starduststorm/belt/README.md

belt move, triangle stay put. that's it. that's the concept.
