starduststorm/belt/case/belt_top_case.stl

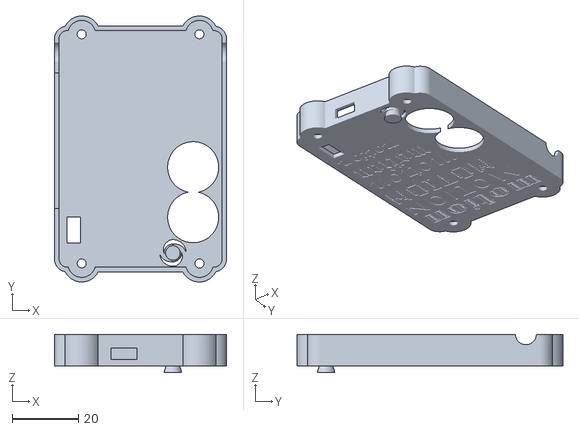
[picture p1: CAD file, 2022-06-10]
case/belt_top_case.stl
52.1 x 80.4 x 11.6
