starduststorm/belt/case/belt_bottom_case.stl

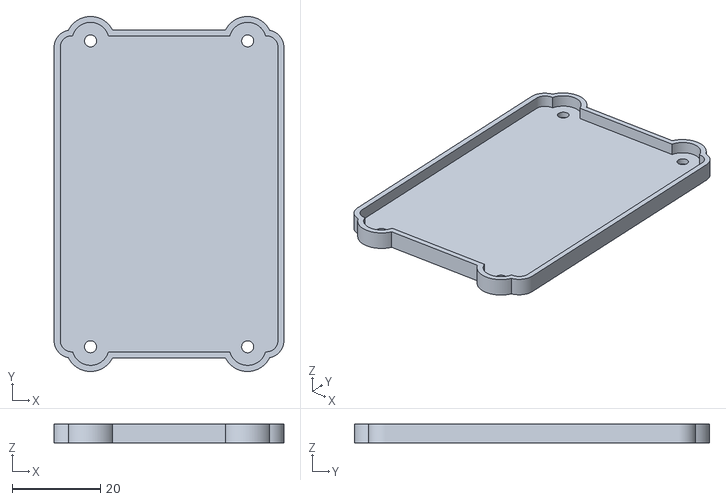
[picture p2: CAD file, 2021-12-14]
case/belt_bottom_case.stl
52.1 x 80.4 x 4.20
