starduststorm/belt/(list of files, cad)

Other CAD files:
case/controller.scad
