starduststorm/belt/board/belt.kicad_pcb

## KiCad design board/belt.kicad_pcb (2021-11-02)

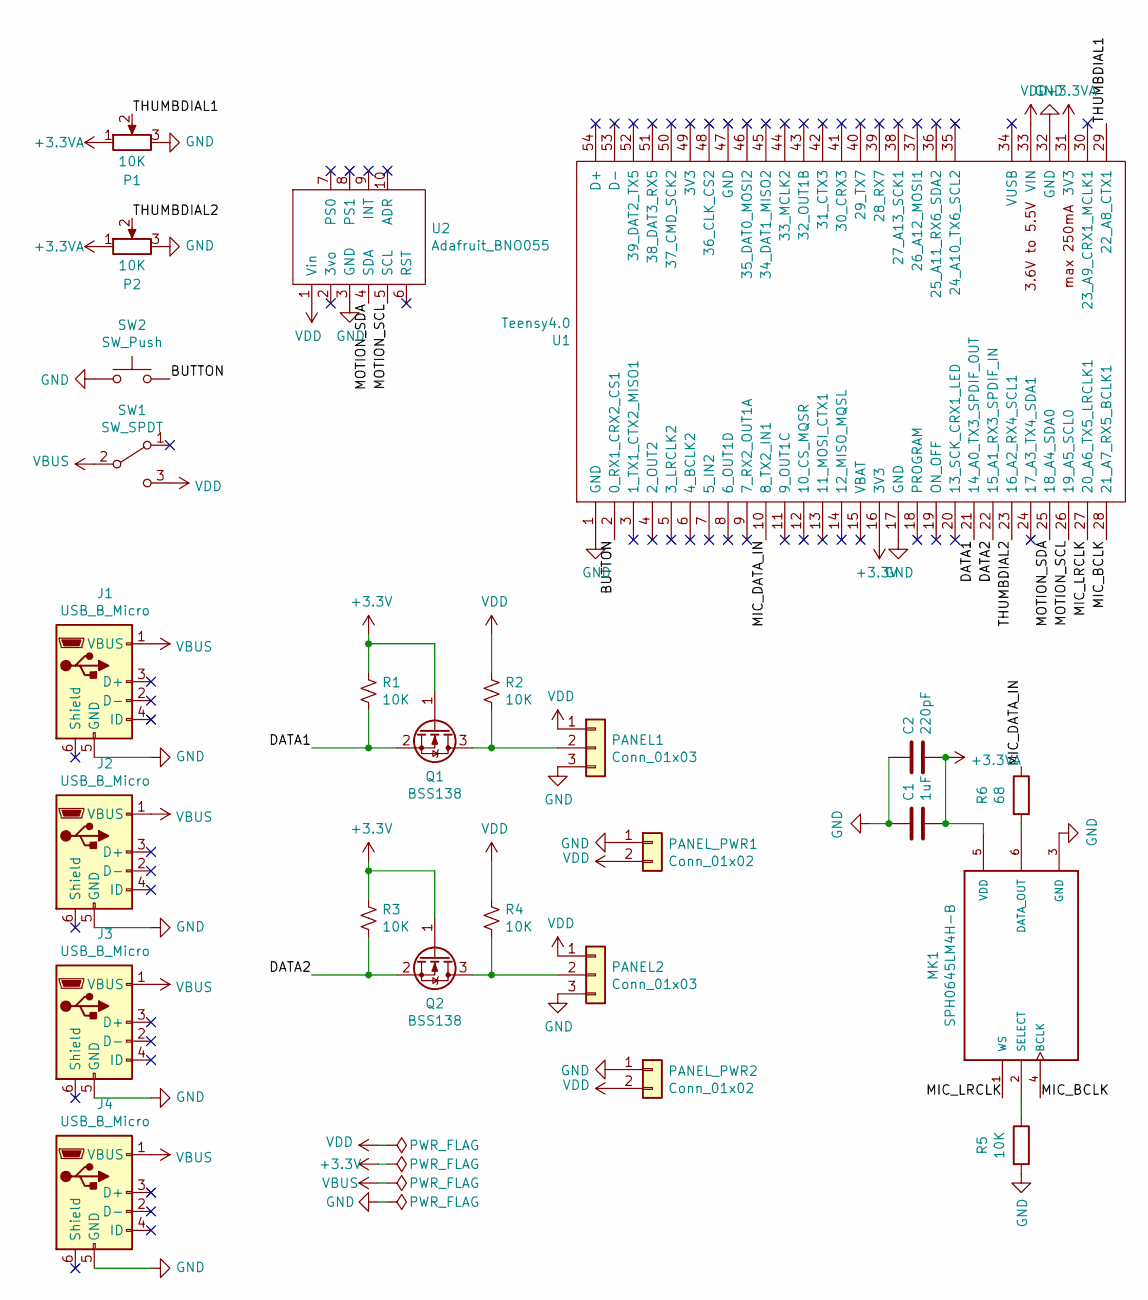
[picture p3: schematic belt.sch]

Parts:
C1: 1uF; C_0805_2012Metric
C2: 220pF; C_0805_2012Metric
J1, J2, J3, J4: USB_B_Micro; USB_Micro-B_Molex-105017-0001
MK1: SPH0645LM4H-B; MIC_SPH0645LM4H-B
P1, P2: 10K; PDB12-H
PANEL1, PANEL2: Conn_01x03; Pad_SMD_01x03
PANEL_PWR1, PANEL_PWR2: Conn_01x02; Pad_SMD_01x02
Q1, Q2: BSS138; SOT-23
R1, R2, R3, R4, R5: 10K; R_0603_1608Metric
R6: 68; R_0805_2012Metric
SW1: SW_SPDT; Button_Switch_SPDT_GH36P010001
SW2: SW_Push; SW_PUSH_6mm_H5mm
U1: Teensy4.0; Teensy40
U2: Adafruit_BNO055

Connections:
+3.3VA: C1.2, C2.2, MK1.5 (VDD), P1.1, P2.1, U1.31 (3V3)
+3V3: Q1.1 (G), Q2.1 (G), R1.1, R3.1, U1.16 (3V3)
/BUTTON: SW2.2, U1.2 (0_RX1_CRX2_CS1)
/DATA1: Q1.2 (S), R1.2, U1.21 (14_A0_TX3_SPDIF_OUT)
/DATA2: Q2.2 (S), R3.2, U1.22 (15_A1_RX3_SPDIF_IN)
/MIC_BCLK: MK1.4 (BCLK), U1.28 (21_A7_RX5_BCLK1)
/MIC_DATA_IN: R6.1, U1.10 (8_TX2_IN1)
/MIC_LRCLK: MK1.1 (WS), U1.27 (20_A6_TX5_LRCLK1)
/MOTION_SCL: U1.26 (19_A5_SCL0), U2.5 (SCL)
/MOTION_SDA: U1.25 (18_A4_SDA0), U2.4 (SDA)
/THUMBDIAL1: P1.2, U1.29 (22_A8_CTX1)
/THUMBDIAL2: P2.2, U1.23 (16_A2_RX4_SCL1)
GND: C1.1, C2.1, J1.5 (GND), J2.5 (GND), J3.5 (GND), J4.5 (GND), MK1.3 (GND), P1.3, P2.3, PANEL1.3, PANEL2.3, PANEL_PWR1.1, PANEL_PWR2.1, R5.2, SW2.1, U1.1 (GND), U1.17 (GND), U1.32 (GND), U2.3 (GND)
unnamed: MK1.2 (SELECT), R5.1
unnamed: MK1.6 (DATA_OUT), R6.2
unnamed: PANEL1.2, Q1.3 (D), R2.2
unnamed: PANEL2.2, Q2.3 (D), R4.2
VBUS: J1.1 (VBUS), J2.1 (VBUS), J3.1 (VBUS), J4.1 (VBUS), SW1.2 (B)
VDD: PANEL1.1, PANEL2.1, PANEL_PWR1.2, PANEL_PWR2.2, R2.1, R4.1, SW1.3 (C), U1.33 (VIN), U2.1 (Vin)

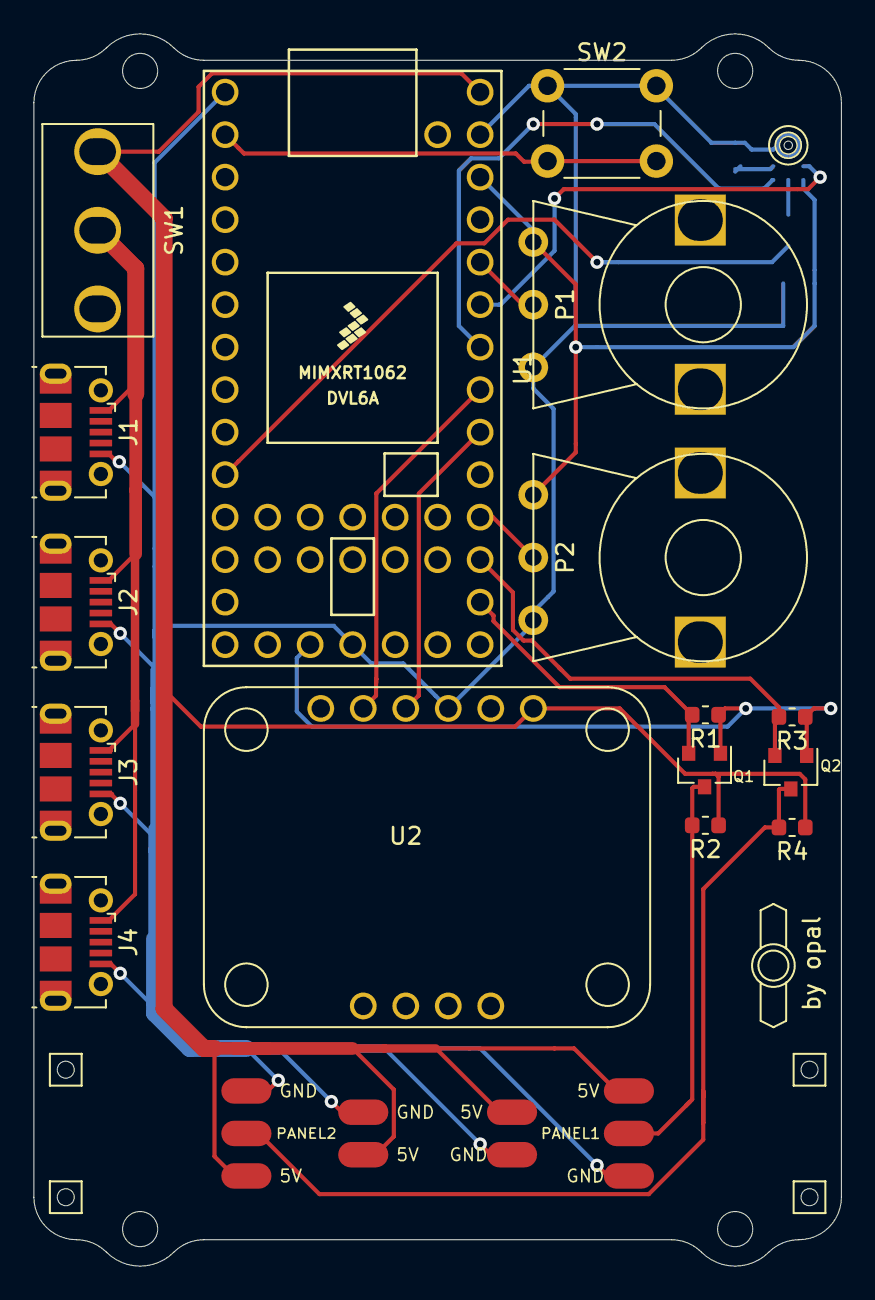
[picture p4: board belt.kicad_pcb from above]

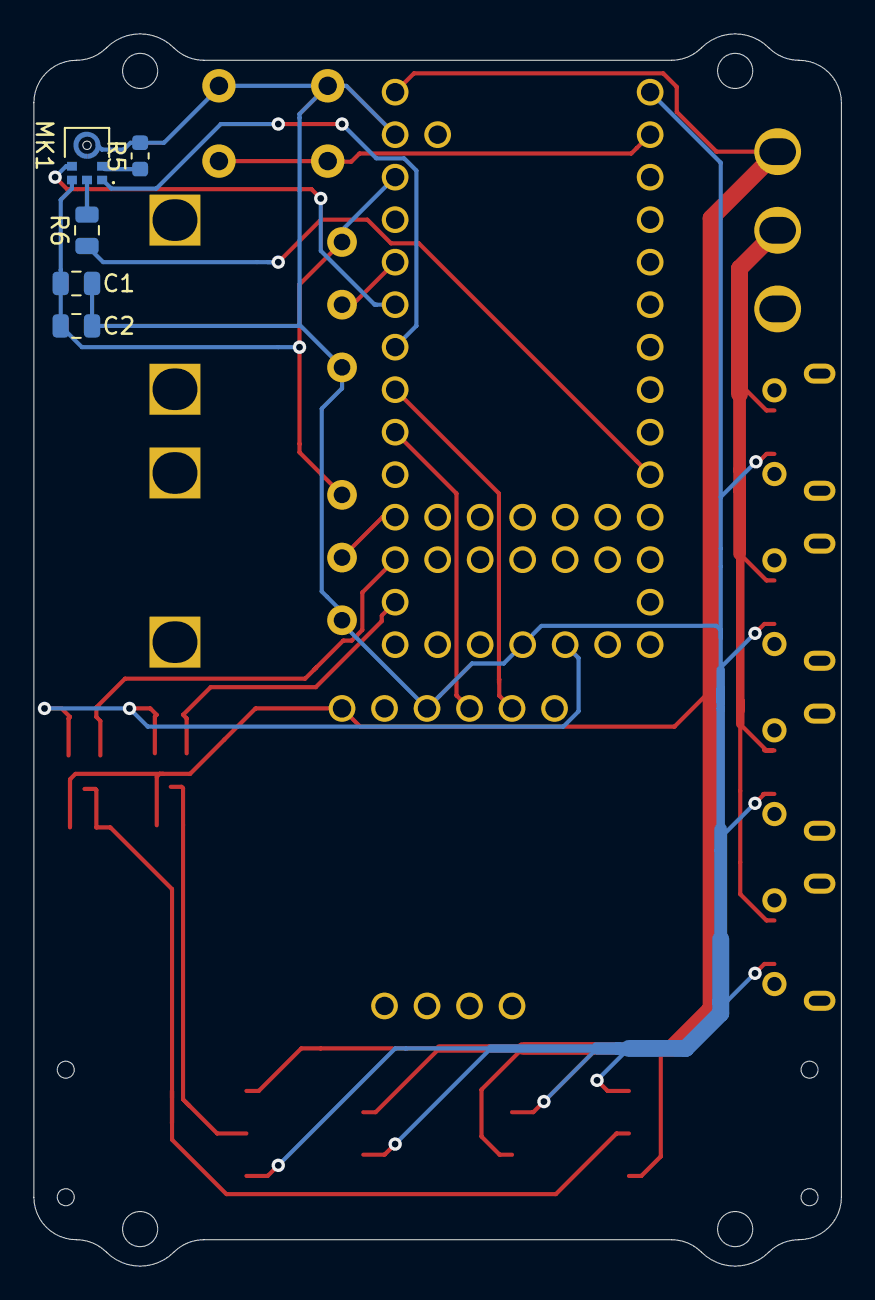
[picture p5: board belt.kicad_pcb from below]

Board: 2 copper layers, 48.3 x 73.6 mm, 25 parts (5 on the bottom side), 19 nets.
