starduststorm/belt/(commit log)

2020-01-29 initial commit of work-in-progress LED belt
    [belt.kicad_pcb, belt.sch]
2020-01-30 first pass at pcb layout; also start looking into adding an NPN switch so that LED current doesn't have to travel through the rest of the board (concerns about wire thickness, heat, etc.)
    [belt.kicad_pcb, belt.sch]
2020-01-31 alternate layout with thick wires and switch on top to avoid needing a transistor to switch power nearby (would likely need a large transistor with a heatsink to manage the current)
    [belt.kicad_pcb, belt.sch]
2020-01-31 shuffle things around some more
    [belt.kicad_pcb]
2020-01-31 polish board edges; add mounting points
    [belt.kicad_pcb]
2020-02-01 move pot and button ports to be nearer by on teensy
    [belt.kicad_pcb, belt.sch]
2020-02-06 mostly done with next board iteration, except for new microphone; use new microphone in software to draw a rainbow fft that is super fun to play with
    [belt.kicad_pcb, belt.sch]
2020-02-08 checkpoint for 3rd board layout with veritcal structure, two pots, and digital mic
    [belt.kicad_pcb, belt.sch]
2020-02-09 new placement for led pads plus a strategy for securing them; tweaks; nearing final design
    [belt.kicad_pcb, belt.sch]
2020-02-09 narrow board width slightly and center led ports on the bottom
    [belt.kicad_pcb]
2020-02-09 digikey was out of the DPDT switch I was going to use, so replace with a smaller (better?) one; shrink board vertically slightly in response
    [belt.kicad_pcb, belt.sch]
2020-02-09 switch 10K resistors to 0603 package (being ambitious and buying in bulk); fix layout for new package
    [belt.kicad_pcb, belt.sch]
2020-02-09 fix schematic symbol which was using old POT symbol
    [belt.kicad_pcb, belt.sch]
2020-02-09 scoot pots apart to sorta be able to fit plastic tops
    [belt.kicad_pcb, belt.sch]
2020-02-09 fix slightly-off board outline cuts
    [belt.kicad_pcb]
2020-02-10 sign it
    [belt.kicad_pcb]
2020-02-10 flip entire board outline vertically which somehow fixed OSHPark thinking the outline wasn't contiguous
    [belt.kicad_pcb]
2020-02-16 factor motion out into a non-pattern manager class; add a pattern based on Adafruit's PixelDust; disable sound processing since it sometimes prevents the teensy from initializing (memory related?)
    [belt.ino, palettes.h, patterns.h, util.h]
2020-02-16 add missing MotionManager file
    [MotionManager.h]
2020-02-25 play with oscillators; first test on assembled board
    [belt.ino, patterns.h]
2020-02-25 sound pattern should draw on every frame even if there is no fft data available; clean up a bit
2020-02-25 add a workaround for the unreliability of audio processing (just initialize motion first); get idle pattern rotation working with current patternset
    [belt.ino, patterns.h, util.h]
2020-02-26 adopt PaletteRotation in Bars, fix a couple bugs in PaletteRotation
    [belt.ino, drawing.h, palettes.h, patterns.h]
2020-02-26 add controls.h to handle pots and button
2020-02-26 add a timeout to wait-for-serial and indicate the issue on panel
    [MotionManager.h, belt.ino, util.h]
2020-02-26 belt -> src
2020-02-27 start porting project to PlatformIO; Audio still broken
    [main.cpp]
2020-02-27 fix an issue with PixelDust starting and stopping multiple times
    [patterns.h]
2020-03-14 changes for first belt-mounted test
2020-03-14 introduce FFTProcessing interface which allows patterns to subscribe to FFT data with a specific number of bins; use this new interface to give Oscillators an audio+motion treatment
    [main.cpp, patterns.h]
2020-03-14 palettize Oscillators; tweaks to color handling and fadedowns, handling low light
    [main.cpp, palettes.h, patterns.h]
2020-03-14 smooth out potentiometer jitter for the brightness dial
    [main.cpp]
2020-03-15 move lsb_noise to util.h; remove 'remap' that had a replacement in FastLED
    [main.cpp, util.h]
2020-03-17 add PatternManager to handle pattern lifecyle; cut out lazyStop and stopCompleted; remove "subPattern"s
2020-03-21 shift palette phase for oscillators to center the palette
    [patterns.h]
2020-03-27 fix an issue where randomness could very rarely cause an assertion failure
    [main.cpp, palettes.h]
2021-07-07 move power switch footprint in a project-specific library and make it a bit more detailed
    [belt.kicad_pcb]
2021-07-08 first draft of a protective case for the belt pcb; a test print yielded tolerances that are too tight in multiple places so it neesd a second draft
    [controller.scad, controller_v1.stl]
2021-07-09 case v2 print looks good & fits!
    [controller.scad, controller_v2.stl]
2021-08-17 modff can't take NULL for its out ptr and somehow this *wasn't* crashing before now?
    [drawing.h]
2021-08-18 smoothly rotate Droplets & Sound patterns to track reverse rotation motion
    [drawing.h, patterns.h, util.h]
2021-08-19 tweak pixeldust motion to track sideways & twirl motion in more interesting ways; add a hack to avoid pixels getting stuck near the back (due to belt neutal position)
    [PatternManager.h, patterns.h]
2021-08-19 wire second analog dial to manual audio gain management
2021-08-19 customary 3am changes prior to the belt's debut event: overhaul 'Motion' pattern to draw bendy arrows in the direction of spin, looks great; reorder patterns; enable previousPattern on double-press; 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
    [PatternManager.h, drawing.h, main.cpp, patterns.h]
2021-11-02 move several belt footprints into local belt footprint library; fix footprints for power switch and BNO055 which had through-holes that were too small
    [belt.kicad_pcb, belt.sch]
2021-11-11 tweak controller button on case for duability since the first one broke after some use
    [belt_controller.3mf, belt_controller.scad, belt_controller.stl, controller_v1.stl]
2021-12-13 Add new "mode" of MotionBlobs SpikeSpin, old now is now ArrowSpin; maybe in the future they can be same again, i.e. switch triggered by a jump or slow fade or something; fix issue where motionmanager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
    [MotionManager.h, PatternManager.h, drawing.h, palettes.h, patterns.h]
2021-12-14 attempt to make case button more durable; tolerance tweaks
    [belt_bottom_case.stl, belt_controller.3mf, belt_controller.scad, belt_controller.stl, belt_top_case.stl, controller_v2.stl]
2022-01-01 add a skeleton for automatic mode switching based on motion data; motion data captured continuously into stats lib; "high" motion variance triggers switch to PixelDust if auto is enabled
2022-03-03 improve automatic pattern switching to crossfade to and from the high motion pattern based on sustained vertical motion variance
2022-03-03 fix the pattern tester
    [PatternManager.h]
2022-03-03 replace janky line drawing with a ported Wu's algorithm for proper antialiased drawing
    [PatternManager.h, drawing.h, patterns.h]
2022-03-08 fix manually changing patterns during the "automatic" mode after it's switched to the high energy mode. "automatic mode" should be an enable-only feature that gets disabled when you set it manually.
    [PatternManager.h, main.cpp]
2022-03-10 sweeping changes: add a twirl overlay in automatic mode that crossfades a random twirl pattern during twirls; export pattern flags statically so I can do things like pick a pattern that does twirl th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
    [MotionManager.h, PatternManager.h, drawing.h, patterns.h]
2022-03-10 fix a build issue with one of the test flags; also add a FIXME for a new issue
    [MotionManager.h, PatternManager.h]
2022-03-10 fix line drawing for Bars pattern
    [MotionManager.h, PatternManager.h, patterns.h]
2022-03-10 tune the pixeldust z-correction to prevent pixels getting stuck on one side or the other during dancing
    [patterns.h]
2022-03-10 shift Oscillators over by one fft bucket since the lowest bucket tends to be omitted or less interesting; also make it twirl
    [patterns.h]
2022-03-11 factor out a WrappedBufferPattern to support full-arc drawing e.g. Compass; factor out some constants and belt-sizing parameters into config.h
2022-03-15 consolidate & cache calls into adafruit BNO and limit to once-per-frame-per-type; fix repeated calls to twirlVelocity improperly updating the accumulator; typical framerate unimproved, but automatic 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
    [MotionManager.h, PatternManager.h, patterns.h]
2022-06-10 more attempts to make the case button more durable
    [belt_controller.scad, belt_top_case.stl]
2022-06-28 compass should keep showing directions if we lose calibration for a short time
    [patterns.h]
2022-10-30 i think zcorrect was over correcting; also some spikespin changes sitting in wc
    [patterns.h]
